katd2137/Wearable-LED-Controller/PCB/PCB_PCB_1_2025-01-16.pdf

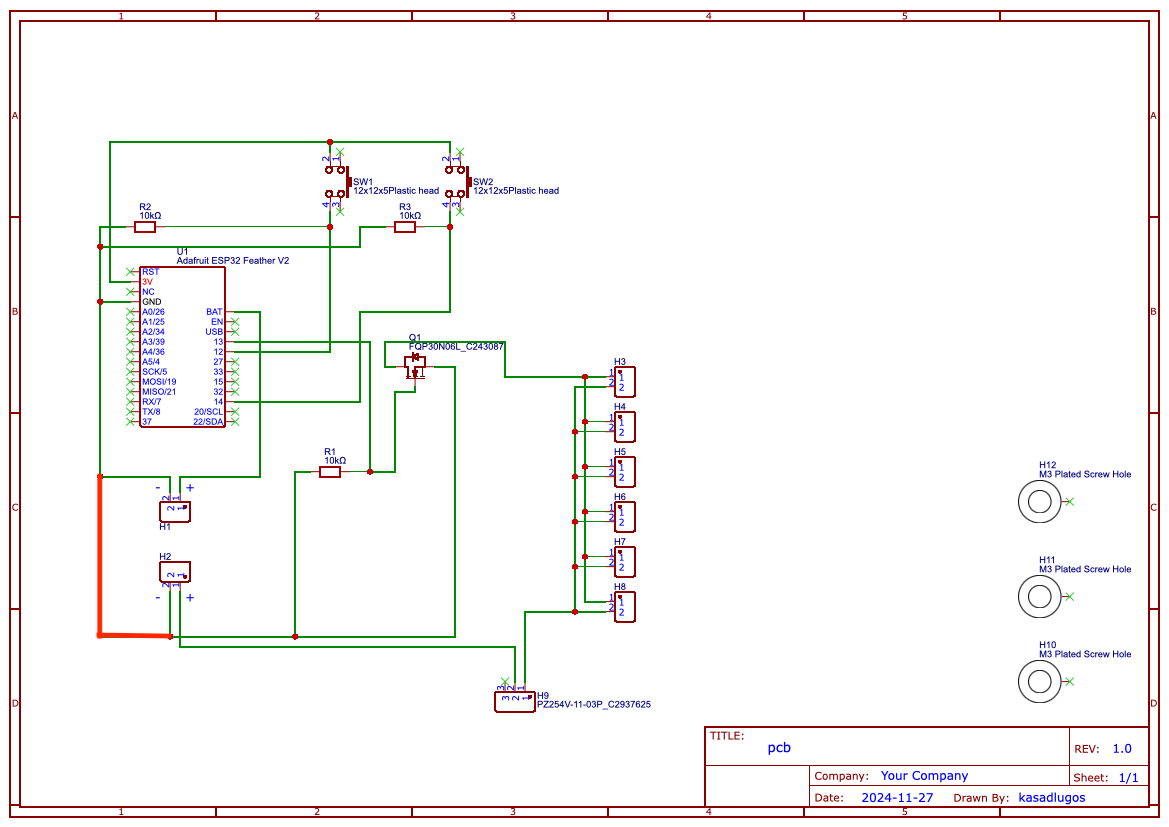
[picture p1: page 1]
