katd2137/Wearable-LED-Controller/PCB/PCB_PCB_1_2025-01-16-3.pdf

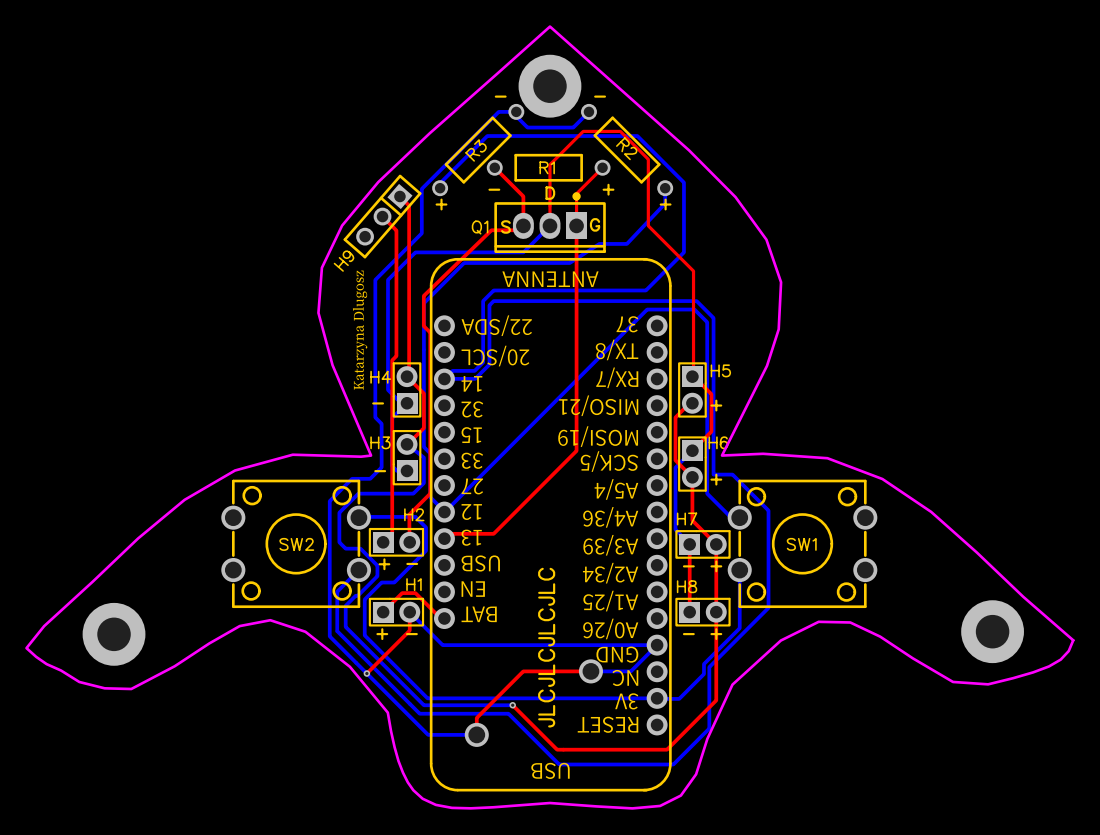
[picture p2: page 1]
