katd2137/Wearable-LED-Controller/(commit log)

2025-01-16 Delete PCB directory
    needed to annotate the new connections
2025-01-16 added a highlighted colour for a new connection
    red line is not implemented on current pub
